Crepaldi2025/TCC2026/documentacao/README.md

# Documentação técnica do protótipo — TCC 2026

Esta pasta reúne a documentação complementar do protótipo desenvolvido para estimar a duração do brilho solar.

O material está organizado em duas partes:

- **Firmware:** fluxograma operacional e mapeamento dos pinos do ESP32-C6.
- **Hardware:** esquemas elétricos extraídos do projeto original da placa de circuito impresso (PCB), desenvolvido no KiCad.

A arquitetura original previa três sensores BH1750 e recursos de comunicação remota. A configuração operacional final utilizou o sensor J11 e o armazenamento dos registros em cartão microSD.

Os esquemas elétricos representam o projeto original da PCB e não necessariamente todas as adaptações realizadas durante os testes em campo.

A descrição dos procedimentos experimentais e dos resultados encontra-se na monografia do TCC.
