Crepaldi2025/TCC2026/documentacao/A_firmware/README.md

Documentação do firmware e mapeamento de pinos do ESP32-C6.
