Crepaldi2025/TCC2026/documentacao/A_firmware/fluxograma_operacional_firmware.png

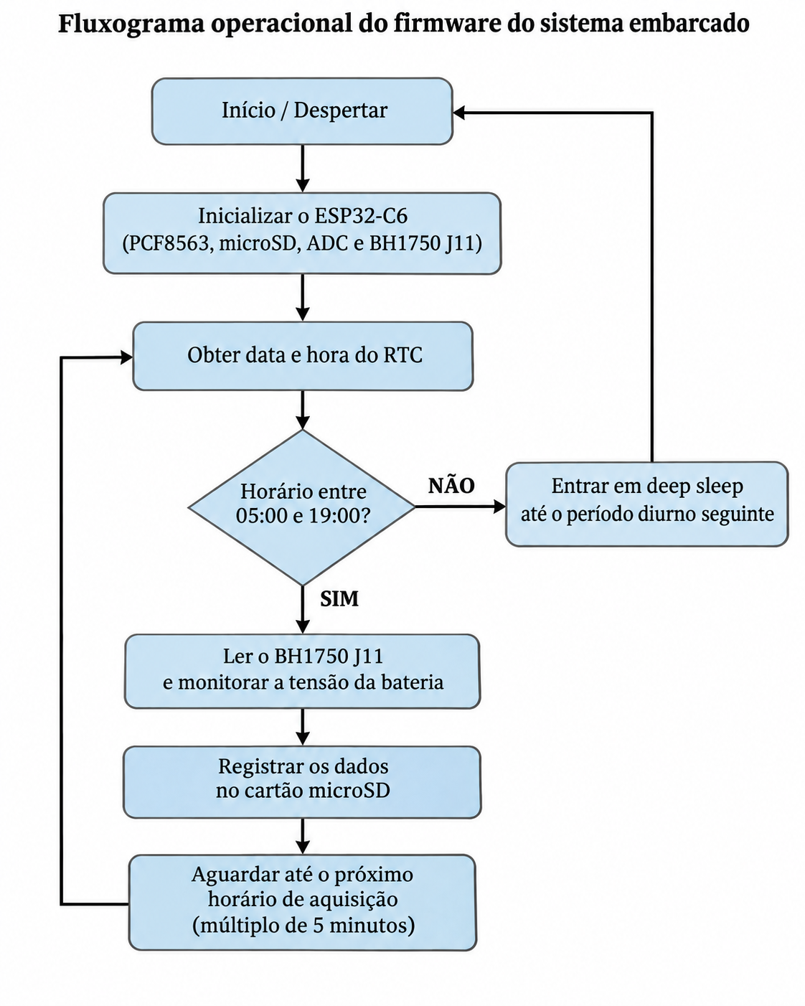
documentacao/A_firmware/fluxograma_operacional_firmware.png
