Crepaldi2025/TCC2026/documentacao/B_kicad_esquemas/01_esp32_c6.png

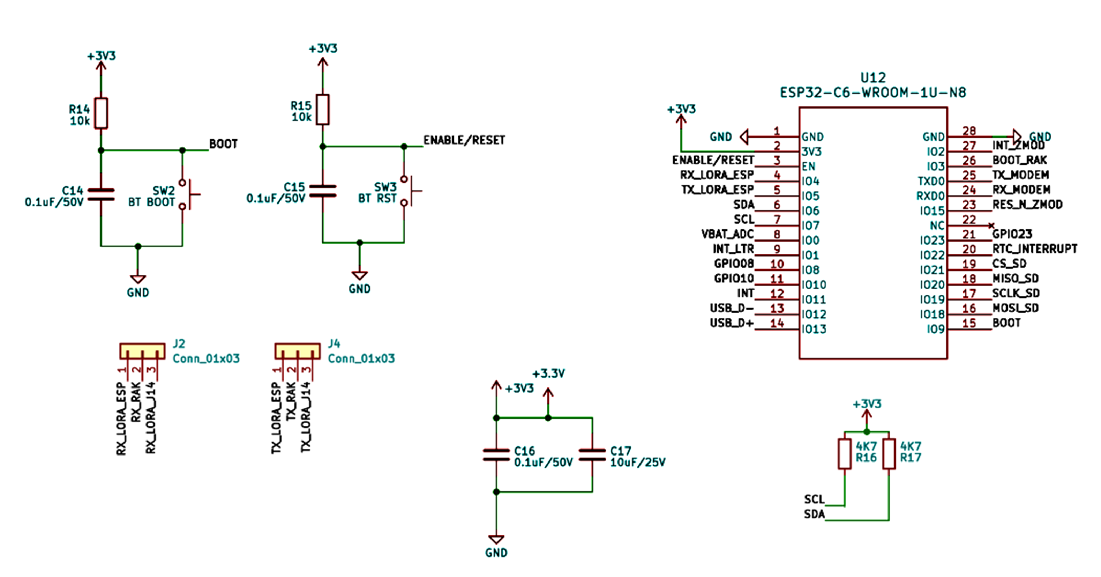
documentacao/B_kicad_esquemas/01_esp32_c6.png
