Crepaldi2025/TCC2026/documentacao/B_kicad_esquemas/02_alimentacao.png

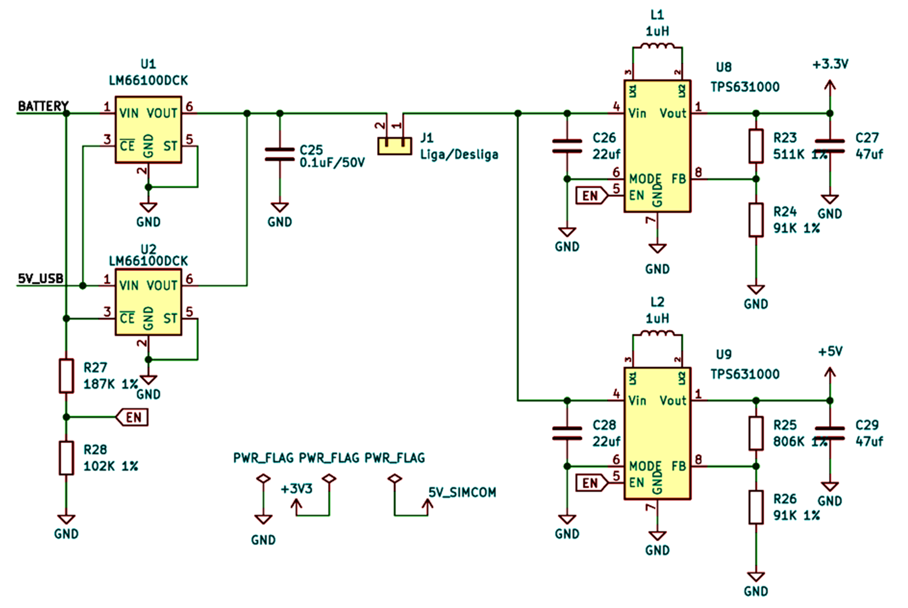
documentacao/B_kicad_esquemas/02_alimentacao.png
