Crepaldi2025/TCC2026/documentacao/B_kicad_esquemas/03_rtc_pcf8563.png

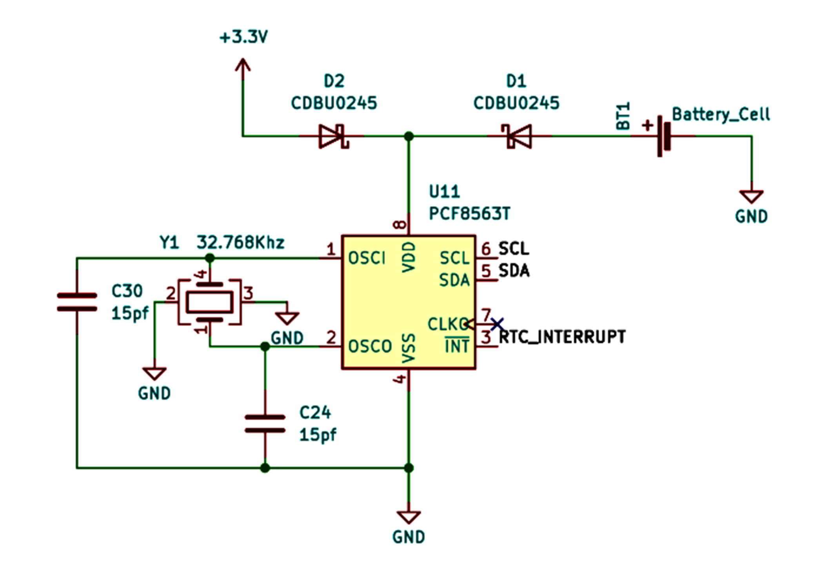
documentacao/B_kicad_esquemas/03_rtc_pcf8563.png
