Crepaldi2025/TCC2026/documentacao/B_kicad_esquemas/04_usb_ch340.png

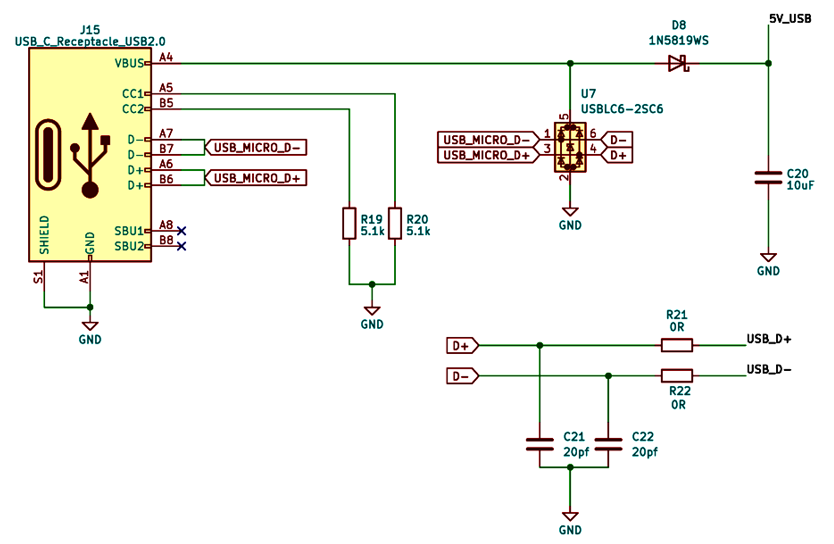
documentacao/B_kicad_esquemas/04_usb_ch340.png
