Crepaldi2025/TCC2026/documentacao/B_kicad_esquemas/05_lora_rak.png

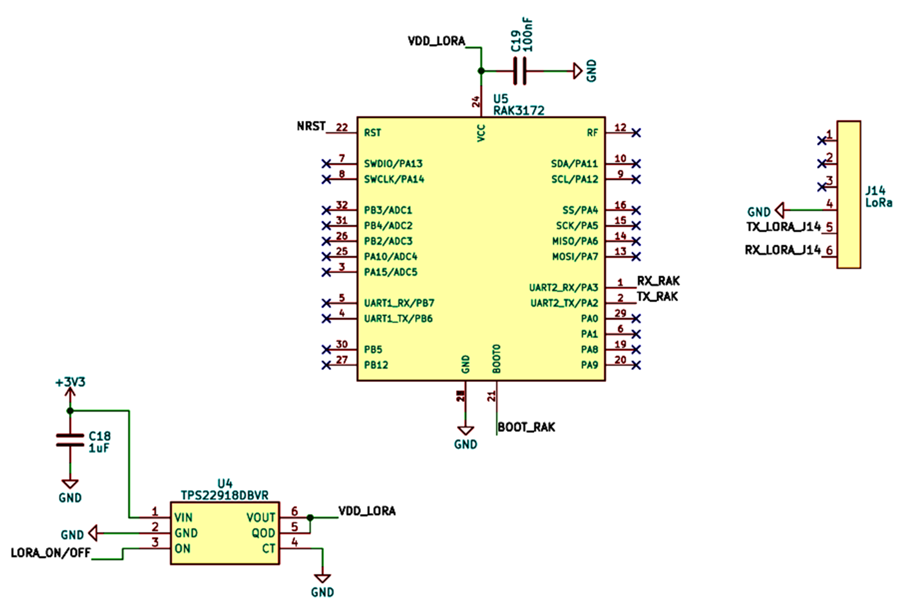
documentacao/B_kicad_esquemas/05_lora_rak.png
