Crepaldi2025/TCC2026/documentacao/B_kicad_esquemas/06_simcom.png

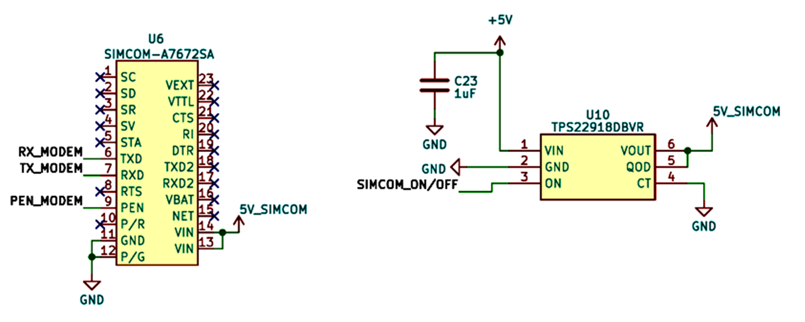
documentacao/B_kicad_esquemas/06_simcom.png
