Crepaldi2025/TCC2026/documentacao/B_kicad_esquemas/07_microsd_kicad.png

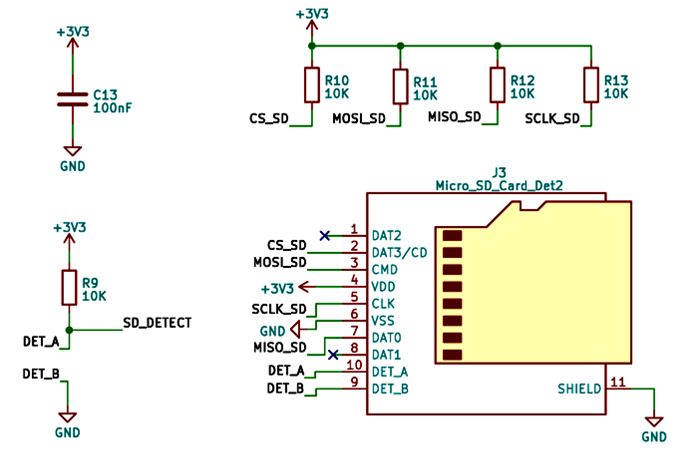
documentacao/B_kicad_esquemas/07_microsd_kicad.png
