Crepaldi2025/TCC2026/results/metricas_modelos_M0_M1_M2.csv

Modelo | N_dias | MAE_min_dia | RMSE_min_dia | Bias_min_dia | R2 | Pearson_r | Spearman_rho | MCC | Balanced_accuracy | Accuracy | Precision | Recall | F1
M0 — J11 + SPA | 46 | 32.97 | 49.05 | 3.01 | 0.8515 | 0.9469 | 0.9471 | 0.8818 | 0.9398 | 0.9409 | 0.9289 | 0.9608 | 0.9446
M1 — J11 + SPA + GOES | 46 | 26.16 | 39.91 | 3.65 | 0.9018 | 0.9618 | 0.9493 | 0.8784 | 0.9387 | 0.9393 | 0.9337 | 0.9519 | 0.9427
M2 — M0 + residual GOES | 46 | 24.95 | 36.77 | -1.54 | 0.9166 | 0.9652 | 0.9553 | 0.8903 | 0.9448 | 0.9453 | 0.9429 | 0.9534 | 0.9481
