Crepaldi2025/TCC2026/results/01_CSD3_M0_M1_M2_46dias.png

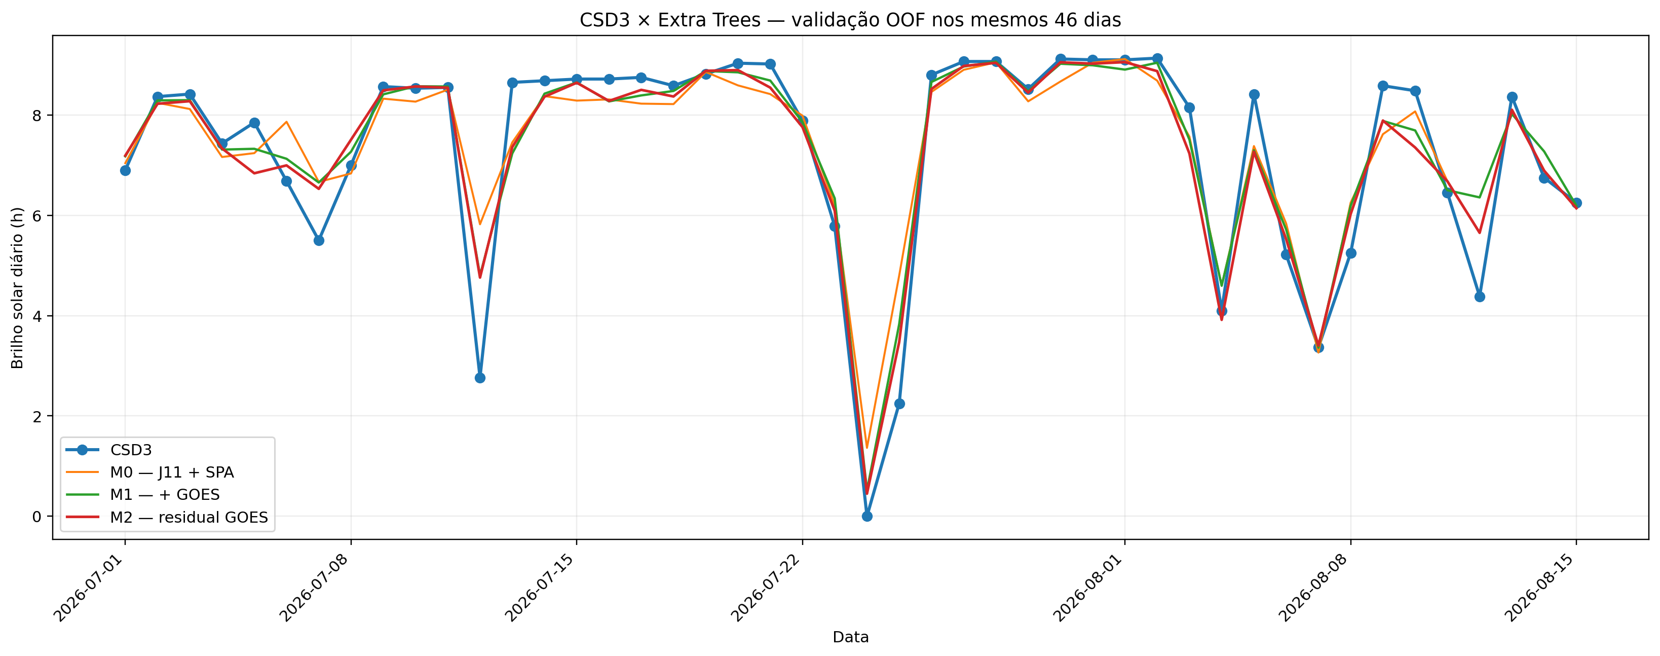
results/01_CSD3_M0_M1_M2_46dias.png
