Crepaldi2025/TCC2026/(commit log)

2026-10-07 Add files via upload
    Adiciona notebook de pré-processamento GOES-19
2026-10-07 Move notebook para pasta notebooks
2026-10-07 Add files via upload
    Adiciona notebooks de modelagem, análise estatística e validação temporal
2026-10-07 Add files via upload
    Adiciona firmware do protótipo ESP32-C6
2026-10-07 Move firmware para pasta do ESP32-C6
2026-10-07 Add README for ESP32-C6 firmware
    Added README.md for ESP32-C6 firmware with details on hardware, acquisition configuration, and future updates.
2026-10-07 Add files via upload
    Adiciona testes estatísticos dos modelos
    [testes_estatisticos_M0_M1_M2.csv]
2026-11-01 Add technical documentation for TCC 2026 prototype
    This file contains technical documentation for the prototype developed to estimate solar brightness duration, including firmware and hardware details.
2026-11-01 Create README.md for ESP32-C6 firmware documentation
    Add documentation for ESP32-C6 firmware and pin mapping.
2026-11-01 Add documentation for CSD3 solar brightness sensor
    Documentação técnica do sensor de duração do brilho solar CSD3, incluindo especificações, aplicações e referências.
2026-11-02 Update README with BH1750 sensor details
    Added information about the BH1750 sensor configuration and data collection intervals.
2026-11-02 Adiciona dados de entrada e inventario SHA256 para reproducao do M2
2026-11-02 Adiciona notebook M2 para reproducao independente pela banca
2026-11-02 Documenta sensor J11 e conexoes do firmware
